DeltaLabo/CanSatWorkshop/README.md

# CanSat Workshop

This project aims to launch a beginner-friendly CanSat workshop, researched, developed, and taught by Delta Lab members.

See the **Issues** tab for tasks.
See you corresponding subsystem folder for more documentation, including architecture diagrams and functional versions.

## Resources

- [General PCB Rules](S&A/PCB_General_Rules.md)

- [Variable Getter Template](OBCC/Variable_Getter_Template.md)

- [LoRa Frame](OBCC/LoRa_Frame.md)

- [Pin Assignment](OBCC/main/pins.h)

- [Systems Engineering References](https://estudianteccr-my.sharepoint.com/:f:/g/personal/kalebgranac13_estudiantec_cr/ElI-9aJQazhGnh5G5kcrWZkB65sbdSAl9rwuSII5qyaB7Q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)

- [Bill of Materials](https://estudianteccr-my.sharepoint.com/:x:/g/personal/kalebgranac13_estudiantec_cr/EeUVlwbXuAFEvggyGM2W0XwBwfjurpy7WgbWl5BY9J1BnA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)

## Requirements

- **Must** be specifically design as a tool for teaching system integration engineering principles.
- **Must** be fully documented for future reproduction by a completely different team
- **Shall** have an instructible document with subsystems descriptions and proposed activities designed for educational purposes

## Administrative Requirements

- Each subsystem **must** create a detailed guide document with clear instructions for assembly, integration, and testing.
- Each subsystem **should** create a list of materials with descriptions, and this list must be in Notion.
- All documents and information for the CanSat project **must be** organized in Github, classified by subsystem, to facilitate access and management.
- All subsystems **must be** compatible with each other in terms of size, connection, and operation, allowing effective integration that facilitates cohesion and overall performance of the CanSat.
- Each subsystem **must** complete a testing and validation process to ensure it meets operational requirements under mission conditions.
