DeltaLabo/CanSatWorkshop/documentation/Subsystems/PDS/PDS.md

# Power Distribution System

Owners: @GaboArayaIA, @JLPL1503, @juanjorojash

The power distribution system is responsible for regulating and supplying the necessary energy to all CanSat components. It maintains a stable and safe power flow, with protections to prevent overcurrent failures and ensure the continuous functionality of the systems in operational conditions.

See [Understanding Capella Physical Diagrams](./../..//Understanding%20Capella%20Physical%20Diagrams/Understanding%20Capella%20Physical%20Diagrams.md) if needed.

## Integration, Verification, and Validation (IVV) Plan

v0.1
v0.1

v0.2
v0.2

v0.3
v0.3

v1.0
v1.0

## Requirements

| **Requirement** | **Verification method** |
| --- | --- |
| The power distribution system must continuously supply 3.3±0.1 V and 1 A, with an efficiency of 95%. | Power Test |
| The power distribution system must con tinuously supply 5±0.1 V and 1 A, with an efficiency of 95%. | Power Test |
| The system must be capable of recover automatically after a fault. | Automatic Recovery Test |

### Success Criteria

The PDS presents a design that ensures stable and efficient power delivery at required voltage and current levels, including automatic recovery capabilities in the event of a fault.
