DeltaLabo/CanSatWorkshop/Workshop/README.md

# Workshop

This team will defined the approach of the workshop. Focused on it’s pedagogy and content.

This team is not obliged to work under SE metodology, but it could be helpful.

Although the administration of the CANSAT project won’t alter the approach, there are some key point to consider:

- Maximum 2 days of Workshop, Hackaton, etc.
- Maximun 30 people in the activity.
