DeltaLabo/CanSatWorkshop/documentation/Subsystems/DPS.md

---
owners: @anthonyarguedas, @abimonge, @ItsMaxXs, @JLPL1503
status: active
---

# Data Processing System

The data processing system manages the reception, storage, and analysis of data collected by the CanSat’s sensors. It organizes and prioritizes information for transmission, enabling real-time reporting and providing positional and orientation data for mission analysis.

See [Understanding Capella Physical Diagrams]() if needed.

## Functional Versions

### v1.0

[Structure Diagram for DPS v1.0. Everything inside the CanSat Physical Component doesn’t belong to DPS and is implemented separately by the OBCC team.]()
