DeltaLabo/CanSatWorkshop/DPS/3dmodel/3dmodel.obj

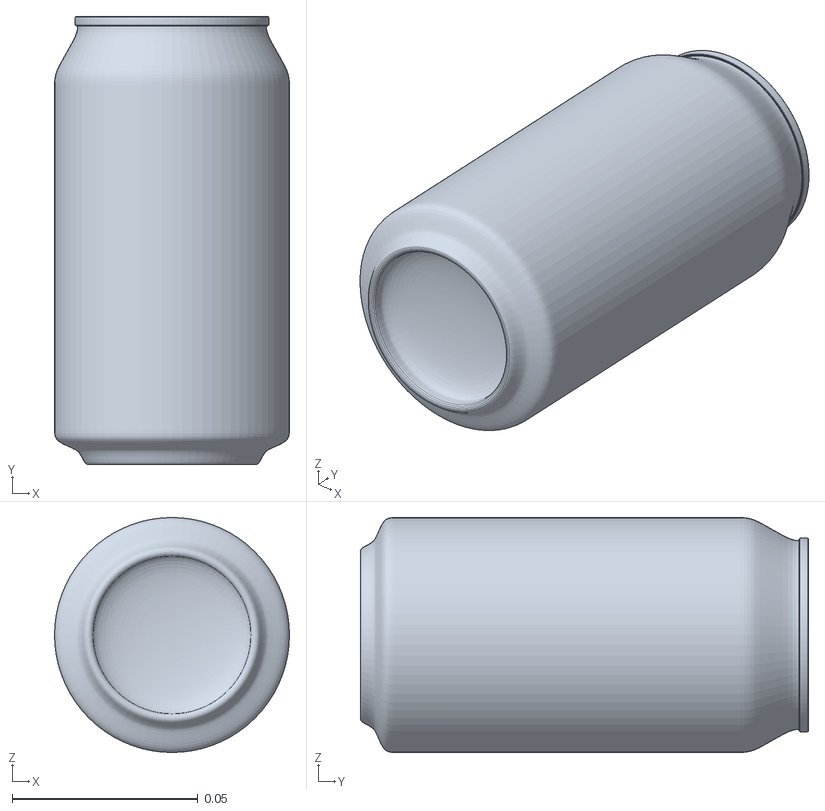
[picture p15: CAD file, 2024-08-20]
DPS/3dmodel/3dmodel.obj
0.0633 x 0.121 x 0.0633
soda-can-a
soda-can-b
