DeltaLabo/CanSatWorkshop/(list of files, drawings)

Other design files:
OBCC/Pin Diagram.fzz
