DeltaLabo/CanSatWorkshop/OBCC/main/pins.h

#ifndef PINS
#define PINS

/******* Begin Comms Pins *******/
#define LORA_TX_PIN D0
#define LORA_RX_PIN D1
/******* End Comms Pins *******/

/******* Begin Sensor Pins *******/
#define GPS_TX_PIN D2
#define GPS_RX_PIN D3
/******* End Sensor Pins *******/

/******* Begin Position and Orientation Pins *******/
/******* End Position and Orientation Pins *******/

#endif
