DeltaLabo/CanSatWorkshop/DPS/ground_station/pins.h

#ifndef PINS
#define PINS

/******* Begin Comms Pins *******/
#define LORA_TX_PIN 13
#define LORA_RX_PIN 12
/******* End Comms Pins *******/

/******* Begin Sensor Pins *******/
/******* End Sensor Pins *******/

/******* Begin Position and Orientation Pins *******/
/******* End Position and Orientation Pins *******/

#endif
