DeltaLabo/CanSatWorkshop/(commit log)

2024-06-05 Create Pin Diagram.fzz
    [Pin Diagram.fzz]
2024-06-05 Create pin definitions file
2024-06-09 Replace LoRA ISR with polling
    [main.ino]
2024-06-11 Create ground station code
2024-06-12 Create ground_station.ino for Heltec
2024-06-12 Add GPS UART pins
2024-06-12 Change UART port for LoRa radio
2024-06-12 Change LoRa radio UART port
2024-06-12 Remove RXString print
2024-06-12 Filter data before sending to PC
2024-06-12 Fix IMU readings
2024-08-20 Upload 3D model IMU visualization
    [3dmodel.obj]
2025-08-25 Subir programación de GPS funcional
2025-08-25 Subir programación de IMU semifuncional
2025-08-25 Codigo semifuncional IMU 3.0
2025-09-03 para pri
2025-09-25 cambios en bom
    [BOM.csv]
2025-09-25 actualizar el BOM
    [BOM.csv]
2026-02-25 Migrate from Notion
    [3dmodel.obj, BOM.csv, Pin Diagram.fzz]
2026-02-25 Hide legacy tests
    [3dmodel.obj]
2026-04-13 Add sensorCorriente for power monitoring
2026-04-14 Remove UART interrupt requirement
2026-04-14 Clarify red links must not attach to functions
2026-04-14 Fix mediated I2C flow in PDS v0.2 diagram
2026-04-14 Fix PDS v0.2 I2C response flows
2026-04-21 Pruebas IMU funcional
2026-04-30 Adjust voltage and current readings with offsets
2026-05-11 imu variable getter for LoRa (OBCC)
    Revisar archivo
2026-06-10 Minimal PDM servo GUI
2026-06-11 Add S&A MBSE testing plan and references
    [pcb_design_inspection_standards.json]
2026-06-11 Add PDM v1.0 test reference corpus
    [servo-pwm-specification.json]
2026-07-02 Update GPS_IMU_Validation_V2.ino
    Correccion_validacion_GPS-IMU
2026-07-02 Freeze hardware naming configuration
    [BOM.csv]
2026-07-02 Select PDS ESS battery architecture
    [BOM.csv]
2026-07-02 PMSE: add shared sensor freshness workplan
2026-07-02 PMSE: add shared sensor freshness contract
2026-07-02 AMS: add shared sensor freshness contract
2026-07-04 Servo open test
2026-07-04 Document PCB manufacturing findings
